MarianoOG/CompuertasUsandoNA/Circuito/Neuronas.JPG

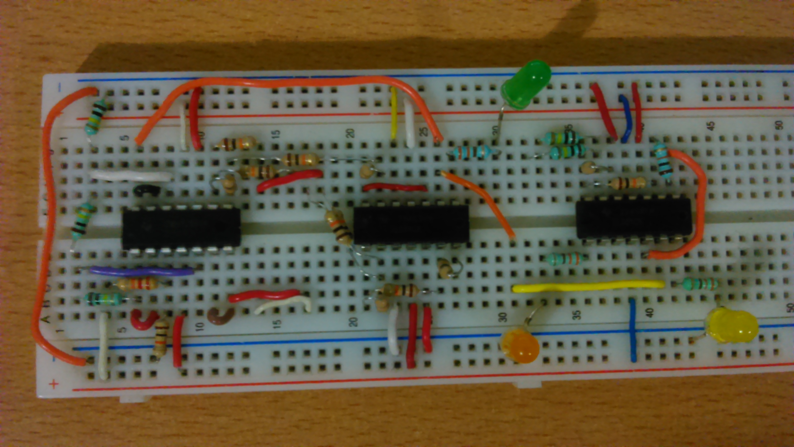
Circuito/Neuronas.JPG
