MarianoOG/CompuertasUsandoNA/README.md

# COMPUERTAS USANDO NEURONAS ARTIFICIALES

En este proyecto escolar he utilizado circuitos electronicos para representar los conceptos de una pequeña red neuronal para compuertas electronicas AND y OR.

Para más información favor de leer el [reporte](REPORTE.pdf).

## Licencia

Este proyecto esta bajo [licencia MIT](LICENSE).
