MarianoOG/CompuertasUsandoNA/Circuito/Neuronas.PDF

B1

R7

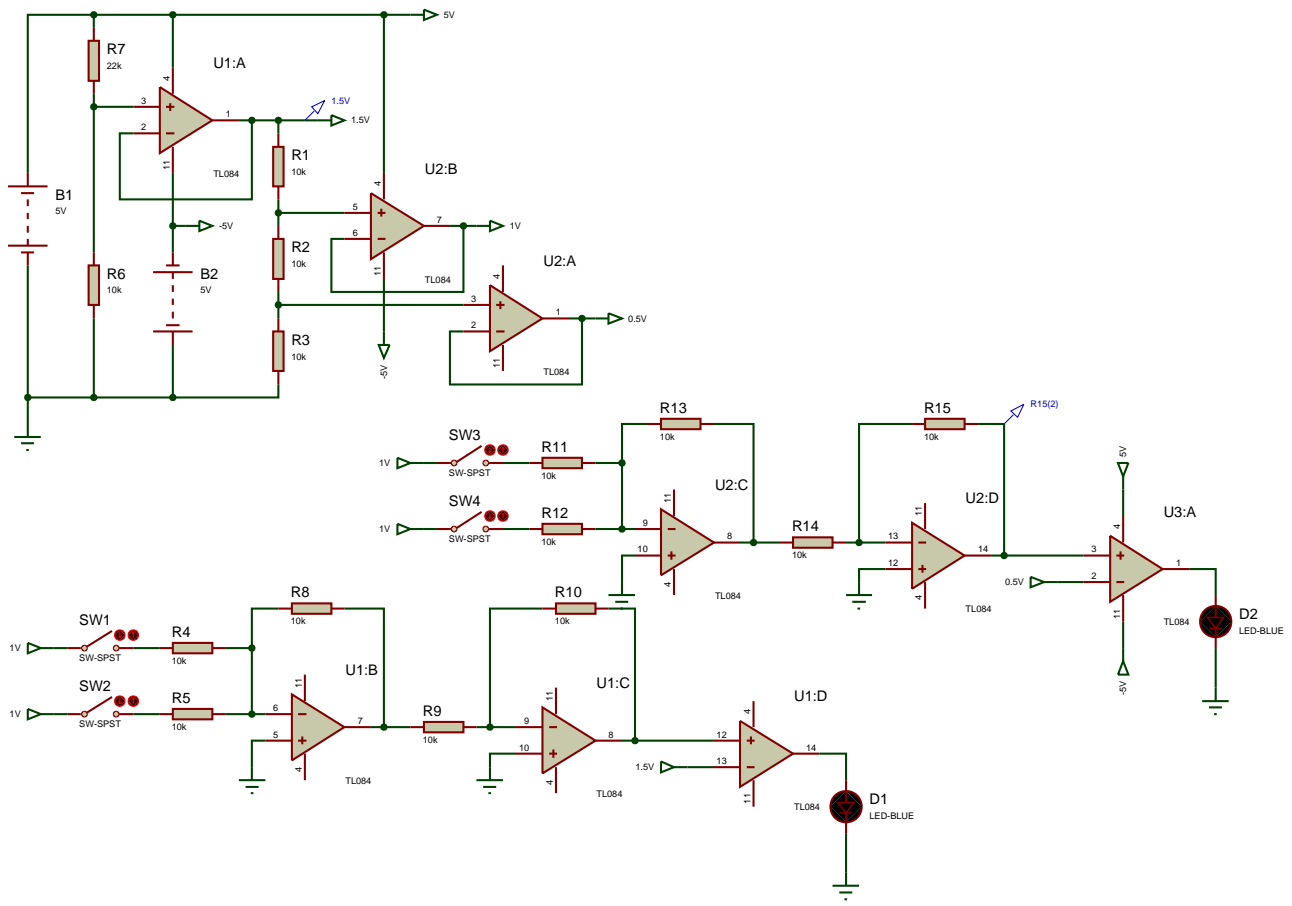
[picture p8: page 1]

SW5

U3:B

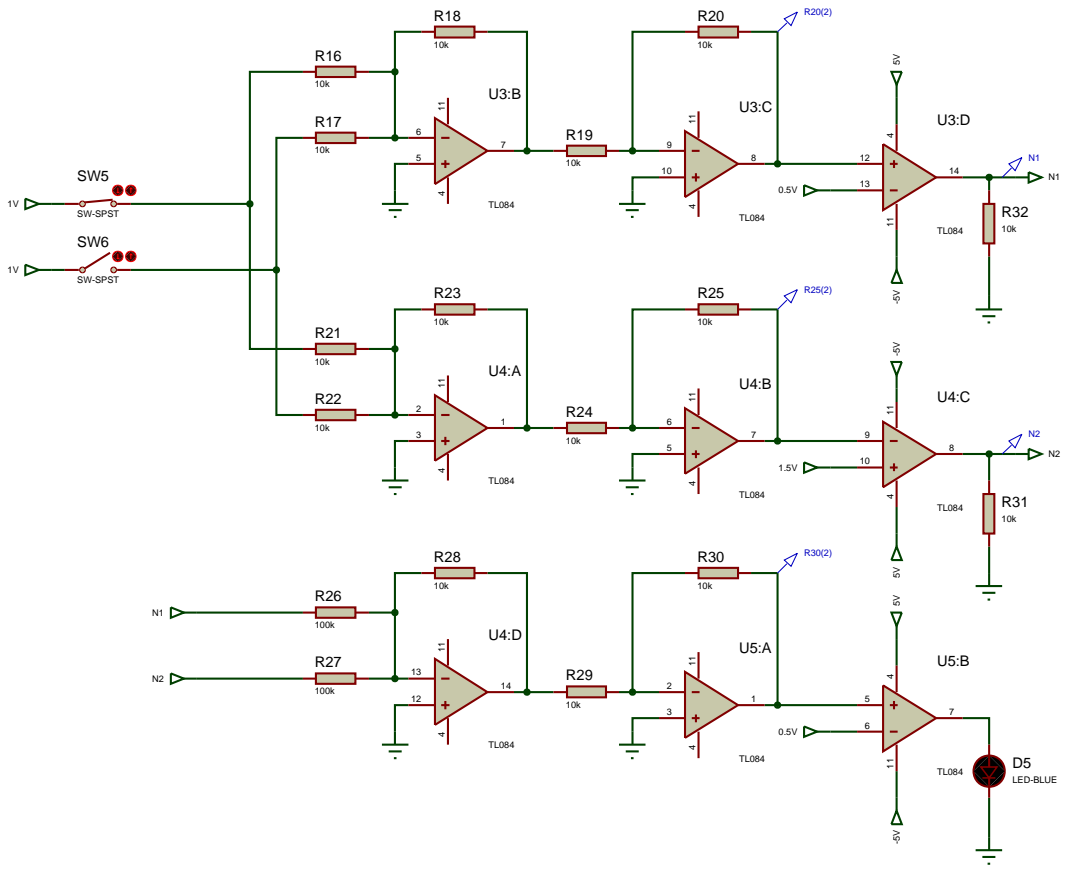
[picture p9: page 2]
