MarianoOG/CompuertasUsandoNA/(list of files, drawings)

Other design files:
Circuito/Neuronas.pdsprj
